emilerenaud/oscillope_extender/Project Outputs for oscilloscope_ext/PDF/Bill of Materials.PDF

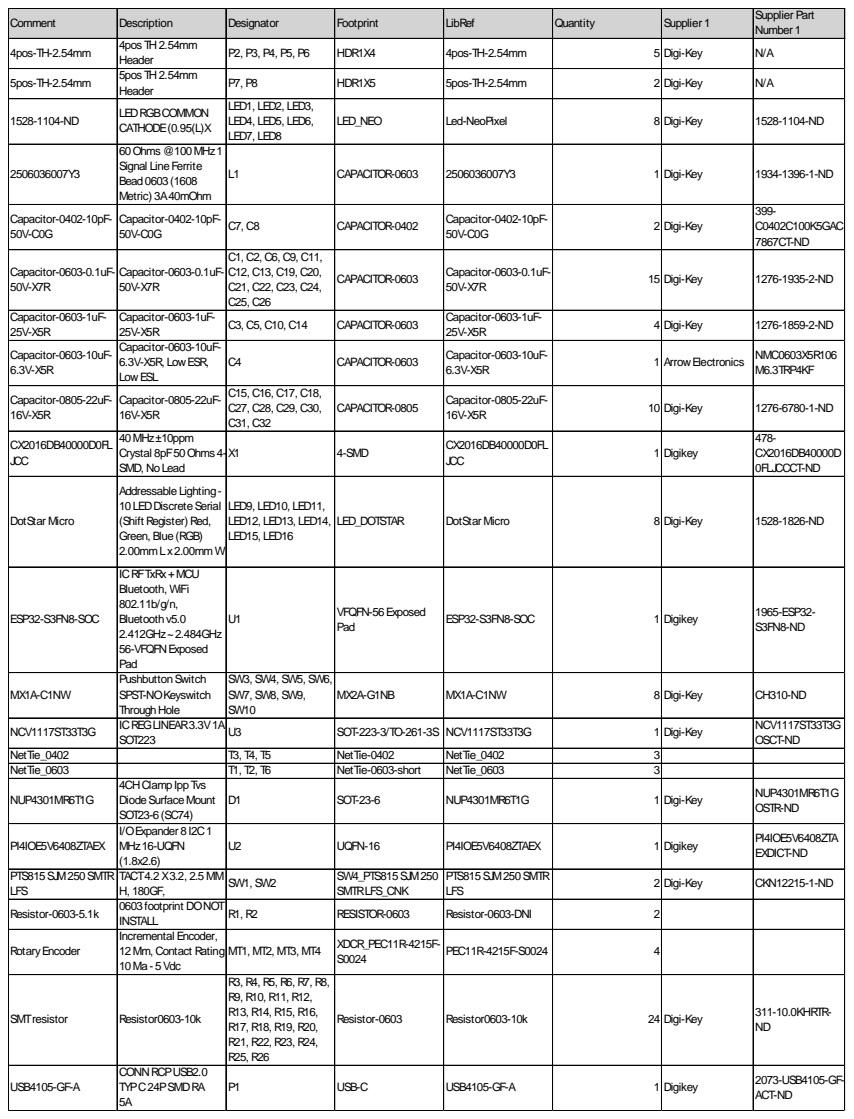
[picture p1: page 1]

Comment | Description | Designator | Footprint | LibRef | Quantity | Supplier 1 | Supplier Part Number 1

4pos-TH-2.54mm | 4pos TH2.54mm Header | P2, P3, P4, P5, P6 | HDR1X4 | 4pos-TH-2.54mm | 5 | Digi-Key | N/A

5pos-TH-2.54mm | 5pos TH2.54mm Header | P7, P8 | HDR1X5 | 5pos-TH-2.54mm | 2 | Digi-Key | N/A

1528-1104-ND | LEDRGBCOMMON CATHODE(0.95(L)X | LED1, LED2, LED3, LED4, LED5, LED6, LED7, LED8 | LED_NEO | Led-NeoPixel | 8 | Digi-Key | 1528-1104-ND

2506036007Y3 | 60Ohms@100MHz1 Signal LineFerrite Bead0603(1608 Metric) 3A40mOhm | L1 | CAPACITOR-0603 | 2506036007Y3 | 1 | Digi-Key | 1934-1396-1-ND

Capacitor-0402-10pF-50V-C0G | Capacitor-0402-10pF-50V-C0G | C7, C8 | CAPACITOR-0402 | Capacitor-0402-10pF-50V-C0G | 2 | Digi-Key | 399-C0402C100K5GAC 7867CT-ND

Capacitor-0603-0.1uF-50V-X7R | Capacitor-0603-0.1uF-50V-X7R | C1, C2, C6, C9, C11, C12, C13, C19, C20, C21, C22, C23, C24, C25, C26 | CAPACITOR-0603 | Capacitor-0603-0.1uF-50V-X7R | 15 | Digi-Key | 1276-1935-2-ND

Capacitor-0603-1uF-25V-X5R | Capacitor-0603-1uF-25V-X5R | C3, C5, C10, C14 | CAPACITOR-0603 | Capacitor-0603-1uF-25V-X5R | 4 | Digi-Key | 1276-1859-2-ND

Capacitor-0603-10uF-6.3V-X5R | Capacitor-0603-10uF-6.3V-X5R, LowESR, LowESL | C4 | CAPACITOR-0603 | Capacitor-0603-10uF-6.3V-X5R | 1 | ArrowElectronics | NMC0603X5R106 M6.3TRP4KF

Capacitor-0805-22uF-16V-X5R | Capacitor-0805-22uF-16V-X5R | C15, C16, C17, C18, C27, C28, C29, C30, C31, C32 | CAPACITOR-0805 | Capacitor-0805-22uF-16V-X5R | 10 | Digi-Key | 1276-6780-1-ND

CX2016DB40000D0FL JCC | 40MHz±10ppm Crystal 8pF50Ohms 4-SMD, NoLead | X1 | 4-SMD | CX2016DB40000D0FL JCC | 1 | Digikey | 478-CX2016DB40000D 0FLJCCCT-ND

DotStar Micro | Addressable Lighting-10LEDDiscreteSerial (Shift Register) Red, Green, Blue(RGB) 2.00mmLx2.00mmW | LED9, LED10, LED11, LED12, LED13, LED14, LED15, LED16 | LED_DOTSTAR | DotStar Micro | 8 | Digi-Key | 1528-1826-ND

ESP32-S3FN8-SOC | ICRFTxRx+MCU Bluetooth, WiFi 802.11b/g/n, Bluetoothv5.0 2.412GHz~2.484GHz 56-VFQFNExposed Pad | U1 | VFQFN-56Exposed Pad | ESP32-S3FN8-SOC | 1 | Digikey | 1965-ESP32-S3FN8-ND

MX1A-C1NW | PushbuttonSwitch SPST-NOKeyswitch ThroughHole | SW3, SW4, SW5, SW6, SW7, SW8, SW9, SW10 | MX2A-G1NB | MX1A-C1NW | 8 | Digi-Key | CH310-ND

NCV1117ST33T3G | ICREGLINEAR3.3V1A SOT223 | U3 | SOT-223-3/TO-261-3S | NCV1117ST33T3G | 1 | Digi-Key | NCV1117ST33T3G OSCT-ND

NetTie_0402 | | T3, T4, T5 | NetTie-0402 | NetTie_0402 | 3
NetTie_0603 | | T1, T2, T6 | NetTie-0603-short | NetTie_0603 | 3
NUP4301MR6T1G | 4CHClampIppTvs DiodeSurfaceMount SOT23-6(SC74) | D1 | SOT-23-6 | NUP4301MR6T1G | 1 | Digi-Key | NUP4301MR6T1G OSTR-ND

PI4IOE5V6408ZTAEX | I/OExpander 8I2C1 MHz16-UQFN (1.8x2.6) | U2 | UQFN-16 | PI4IOE5V6408ZTAEX | 1 | Digikey | PI4IOE5V6408ZTA EXDICT-ND

PTS815SJM250SMTR LFS | TACT4.2X3.2, 2.5 MM H, 180GF, | SW1, SW2 | SW4_PTS815SJM250 SMTRLFS_CNK | PTS815SJM250SMTR LFS | 2 | Digi-Key | CKN12215-1-ND

Resistor-0603-5.1k | 0603footprint DONOT INSTALL | R1, R2 | RESISTOR-0603 | Resistor-0603-DNI | 2

RotaryEncoder | Incremental Encoder, 12Mm, Contact Rating 10Ma- 5Vdc | MT1, MT2, MT3, MT4 | XDCR_PEC11R-4215F-S0024 | PEC11R-4215F-S0024 | 4

SMTresistor | Resistor0603-10k | R3, R4, R5, R6, R7, R8, R9, R10, R11, R12, R13, R14, R15, R16, R17, R18, R19, R20, R21, R22, R23, R24, R25, R26 | Resistor-0603 | Resistor0603-10k | 24 | Digi-Key | 311-10.0KHRTR-ND

USB4105-GF-A | CONNRCPUSB2.0 TYPC24PSMDRA 5A | P1 | USB-C | USB4105-GF-A | 1 | Digikey | 2073-USB4105-GF-ACT-ND
