emilerenaud/oscillope_extender/CAD/oscilloscope_ext_assy.SLDASM

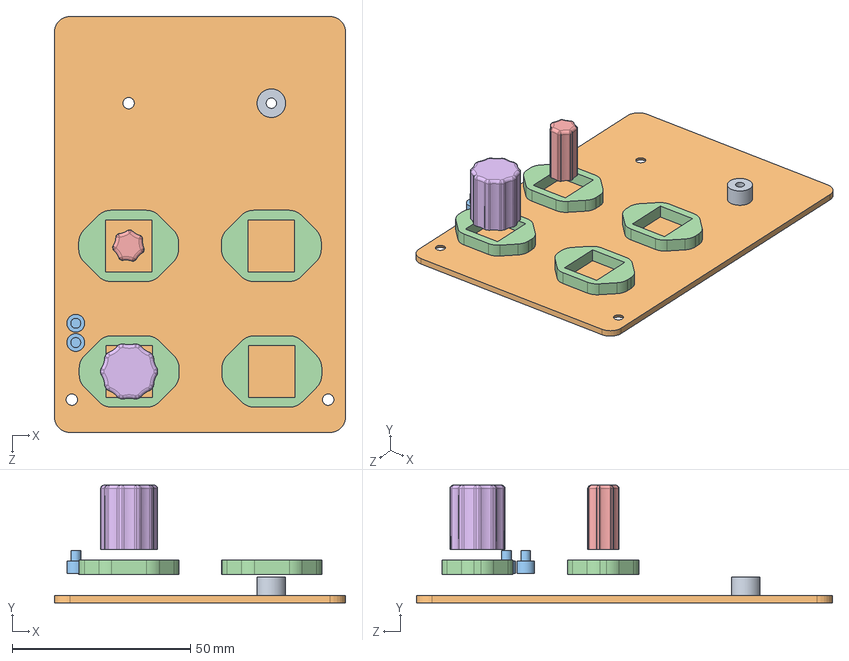
[picture p2: CAD file, 2025-07-10]
CAD/oscilloscope_ext_assy.SLDASM
81.6 x 33.0 x 116.6 mm
big_knob2
small_knob
diffuser x 4
pin_button x 2
base_plate
base_plate_insert
