emilerenaud/oscillope_extender/CAD/keycap.SLDPRT

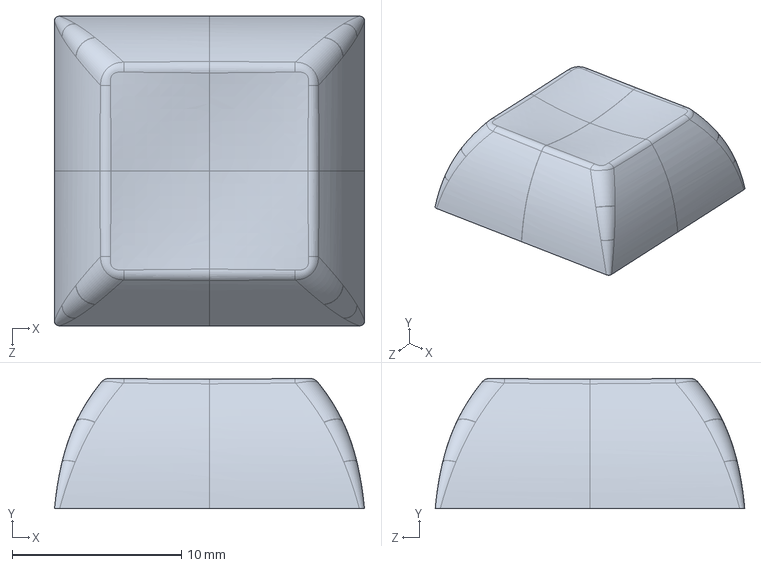
[picture p3: CAD file, 2025-07-10]
CAD/keycap.SLDPRT
18.3 x 7.69 x 18.3 mm
