emilerenaud/oscillope_extender/CAD/pin_button.SLDPRT

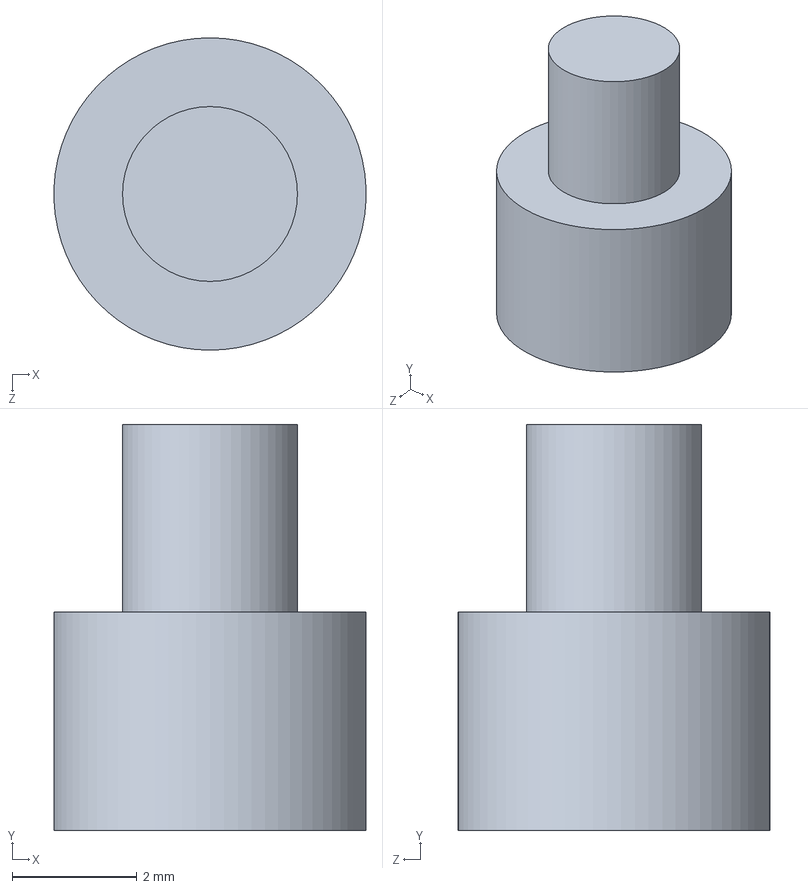
[picture p4: CAD file, 2025-07-10]
CAD/pin_button.SLDPRT
4.99 x 6.50 x 5.00 mm
