emilerenaud/oscillope_extender/CAD/top_casing.SLDPRT

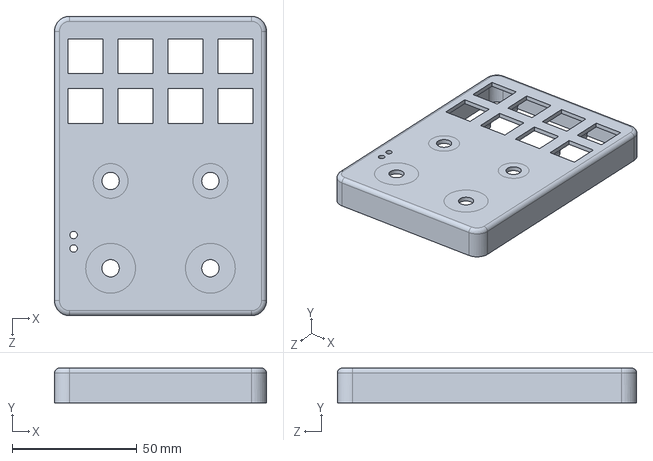
[picture p5: CAD file, 2025-07-10]
CAD/top_casing.SLDPRT
85.0 x 14.0 x 120.0 mm
