emilerenaud/oscillope_extender/CAD/base_plate_insert.SLDPRT

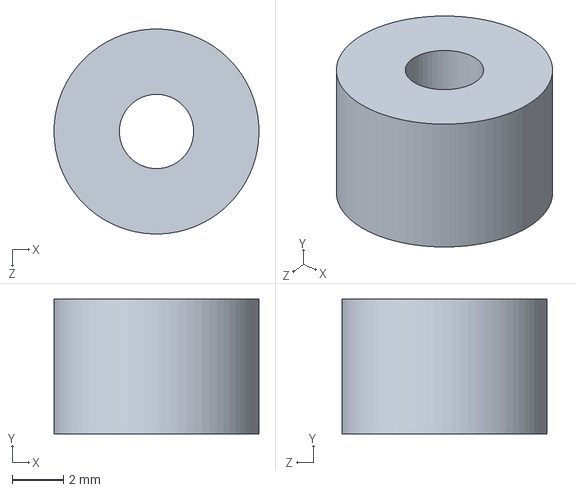
[picture p6: CAD file, 2025-07-10]
CAD/base_plate_insert.SLDPRT
8.00 x 5.25 x 8.00 mm
