emilerenaud/oscillope_extender/CAD/small_knob.SLDPRT

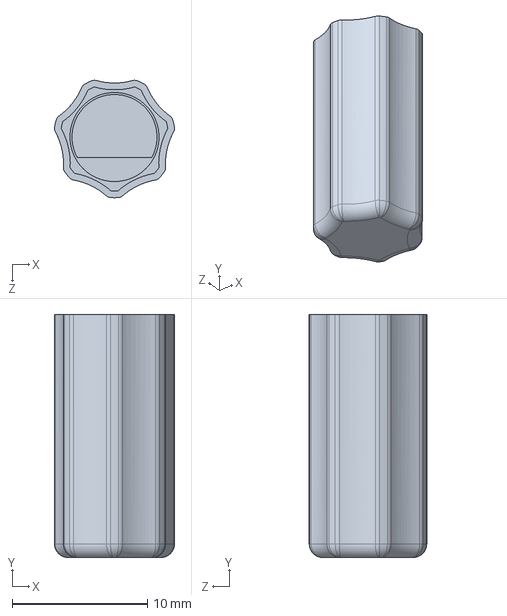
[picture p7: CAD file, 2025-07-10]
CAD/small_knob.SLDPRT
8.90 x 18.0 x 8.71 mm
