emilerenaud/oscillope_extender/CAD/base_plate.SLDPRT

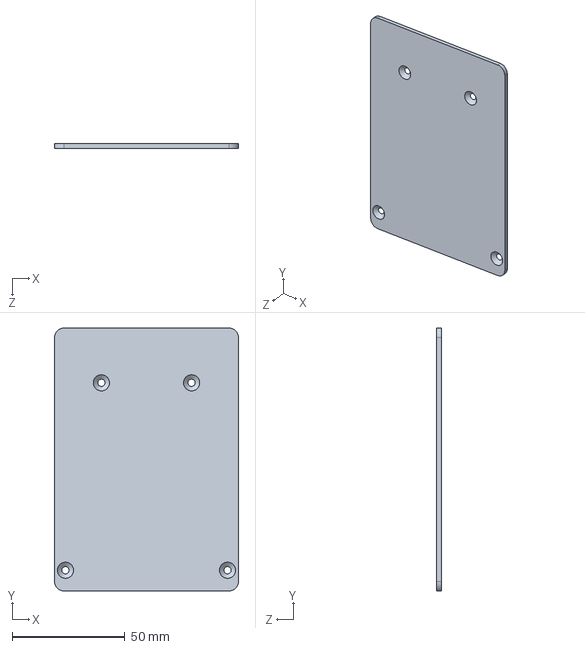
[picture p8: CAD file, 2025-07-10]
CAD/base_plate.SLDPRT
81.6 x 116.6 x 2.00 mm
