emilerenaud/oscillope_extender/CAD/diffuser.SLDPRT

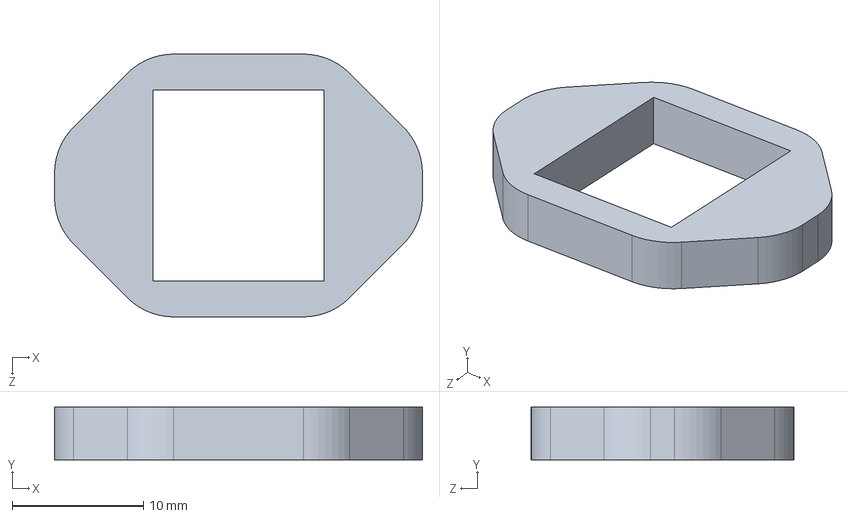
[picture p9: CAD file, 2025-07-10]
CAD/diffuser.SLDPRT
28.0 x 4.00 x 20.0 mm
