emilerenaud/oscillope_extender/CAD/big_knob2.SLDPRT

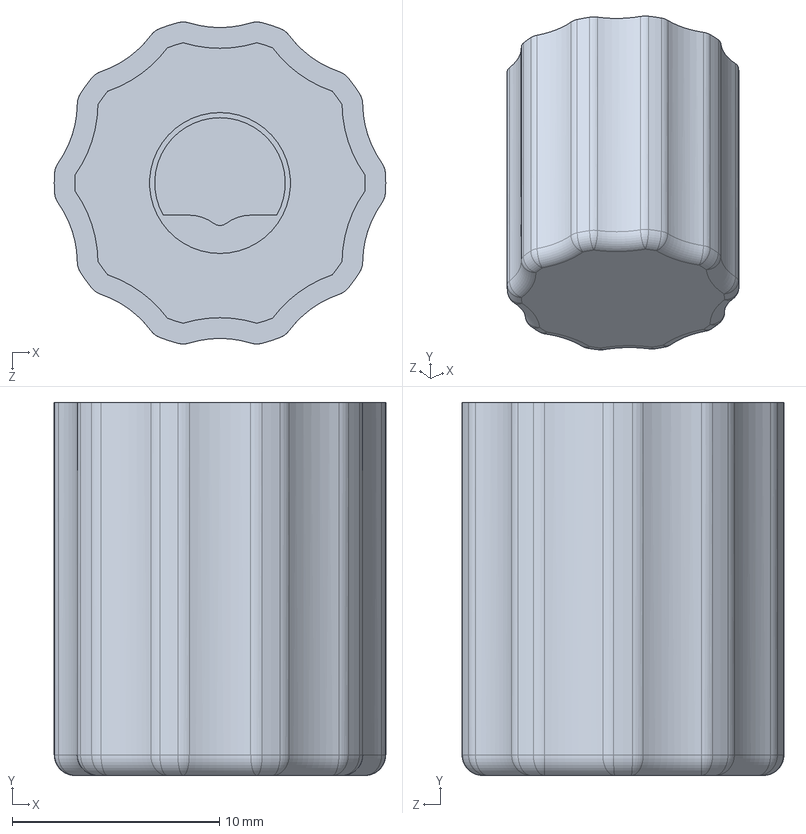
[picture p10: CAD file, 2025-07-10]
CAD/big_knob2.SLDPRT
16.0 x 18.0 x 15.5 mm
