emilerenaud/oscillope_extender/CAD/big_knob.SLDPRT

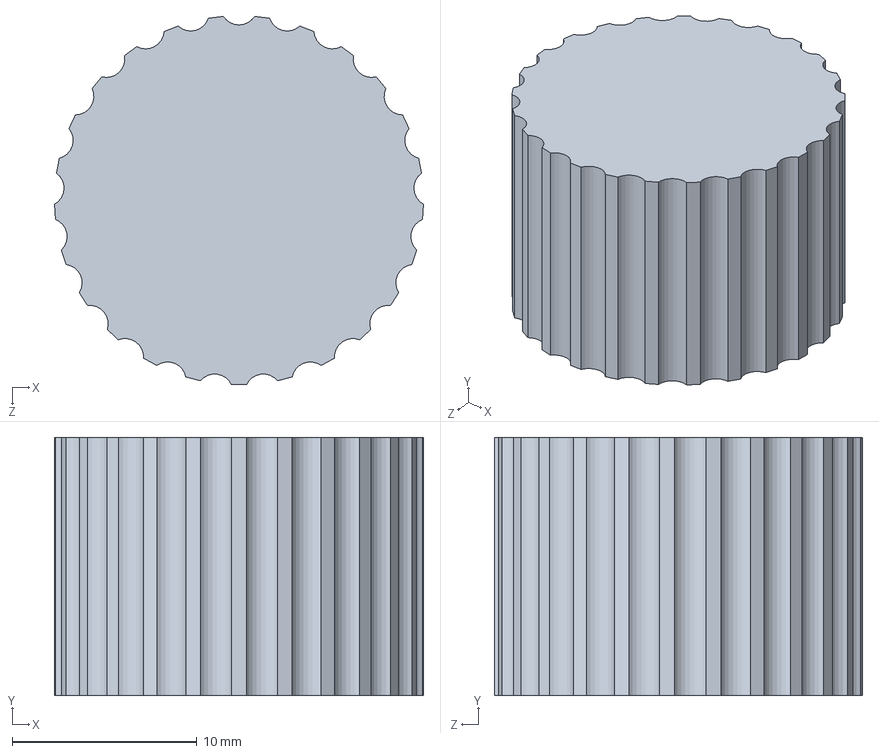
[picture p11: CAD file, 2025-06-17]
CAD/big_knob.SLDPRT
20.0 x 14.0 x 20.0 mm
