emilerenaud/oscillope_extender/CAD/light_ring_20mm.SLDPRT

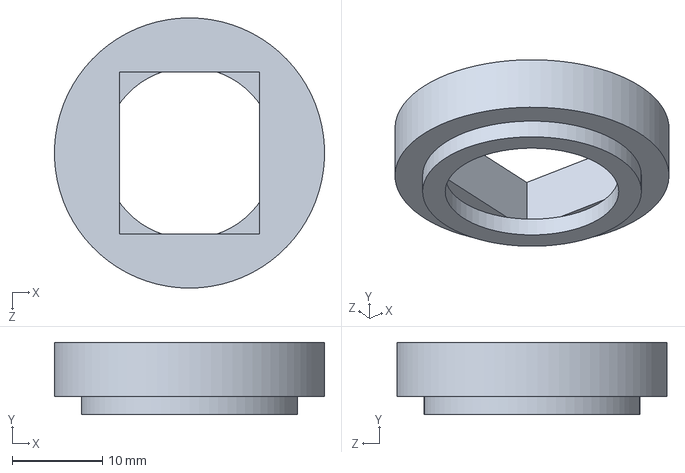
[picture p12: CAD file, 2025-06-17]
CAD/light_ring_20mm.SLDPRT
30.0 x 8.00 x 30.0 mm
