emilerenaud/oscillope_extender/CAD/Cherry MX.STEP

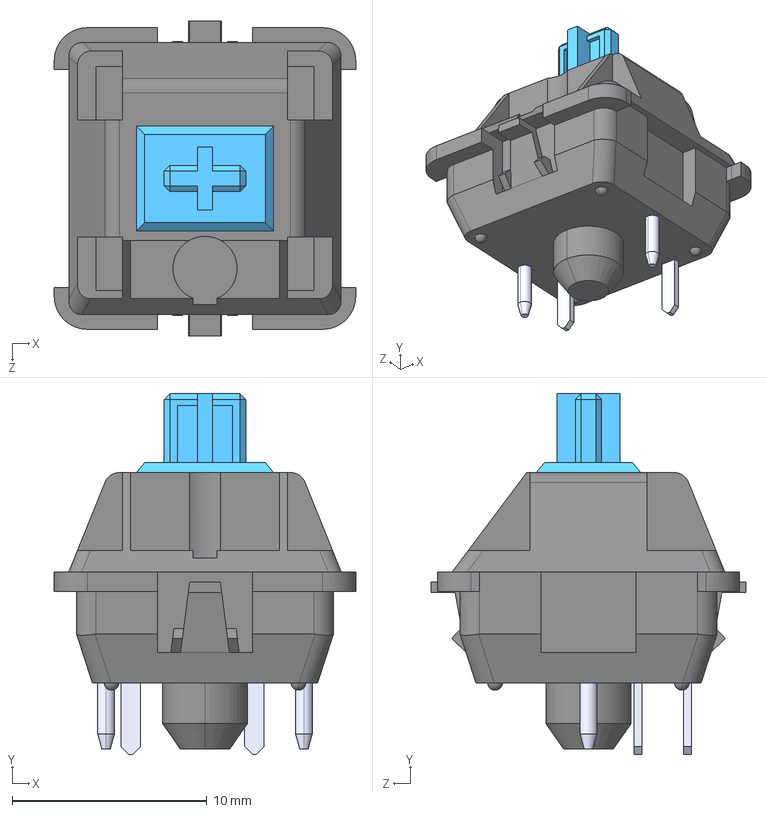
[picture p13: CAD file, 2025-06-17]
CAD/Cherry MX.STEP
15.5 x 18.5 x 16.2 mm
