emilerenaud/oscillope_extender/CAD/top_casing_light.SLDPRT

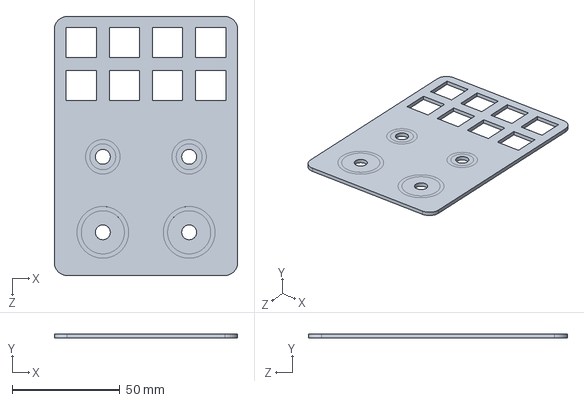
[picture p14: CAD file, 2025-06-17]
CAD/top_casing_light.SLDPRT
85.0 x 2.00 x 120.0 mm
