emilerenaud/oscillope_extender/CAD/encoder.stp

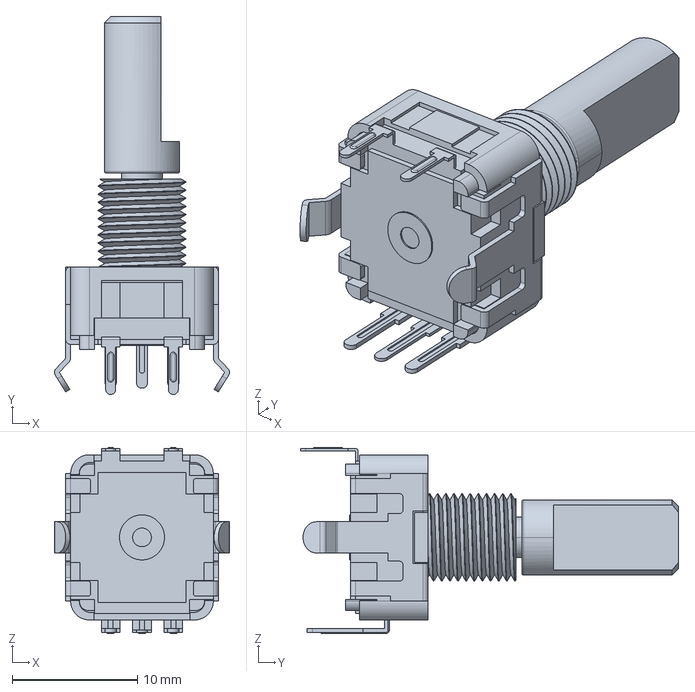
[picture p15: CAD file, 2025-06-17]
CAD/encoder.stp
14.0 x 30.2 x 14.9 mm
