emilerenaud/oscillope_extender/CAD/light_ring_20mm_inside.SLDPRT

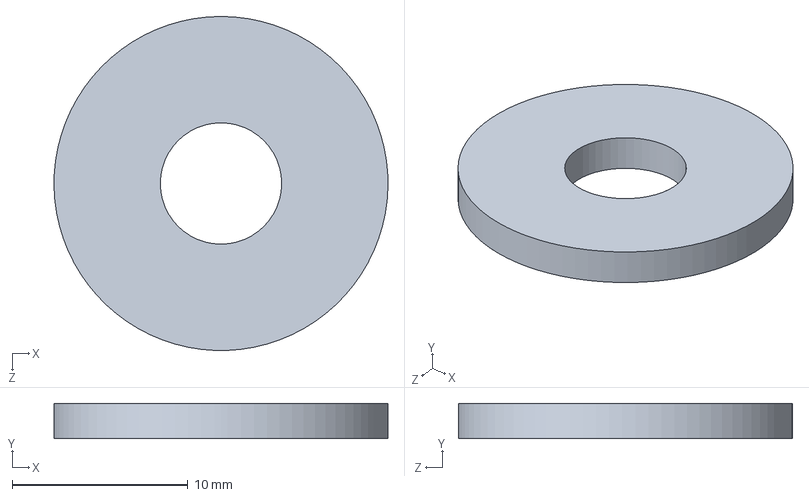
[picture p16: CAD file, 2025-06-17]
CAD/light_ring_20mm_inside.SLDPRT
19.0 x 2.00 x 19.0 mm
