emilerenaud/oscillope_extender/(list of files, cad)

Other CAD files:
CAD/DSA_Keycap_CherryMX.step
CAD/_STL/base_plate.STL
CAD/_STL/base_plate_insert.STL
CAD/_STL/big_knob.STL
CAD/_STL/big_knob2.STL
CAD/_STL/diffuser.STL
CAD/_STL/keycap.STL
CAD/_STL/light_ring_20mm.STL
CAD/_STL/light_ring_20mm_inside.STL
CAD/_STL/pin_button.STL
CAD/_STL/small_knob.STL
CAD/_STL/top_casing.STL
CAD/_STL/top_casing_light.STL
