emilerenaud/oscillope_extender/Project Outputs for oscilloscope_ext/PDF/Schematic Prints.PDF

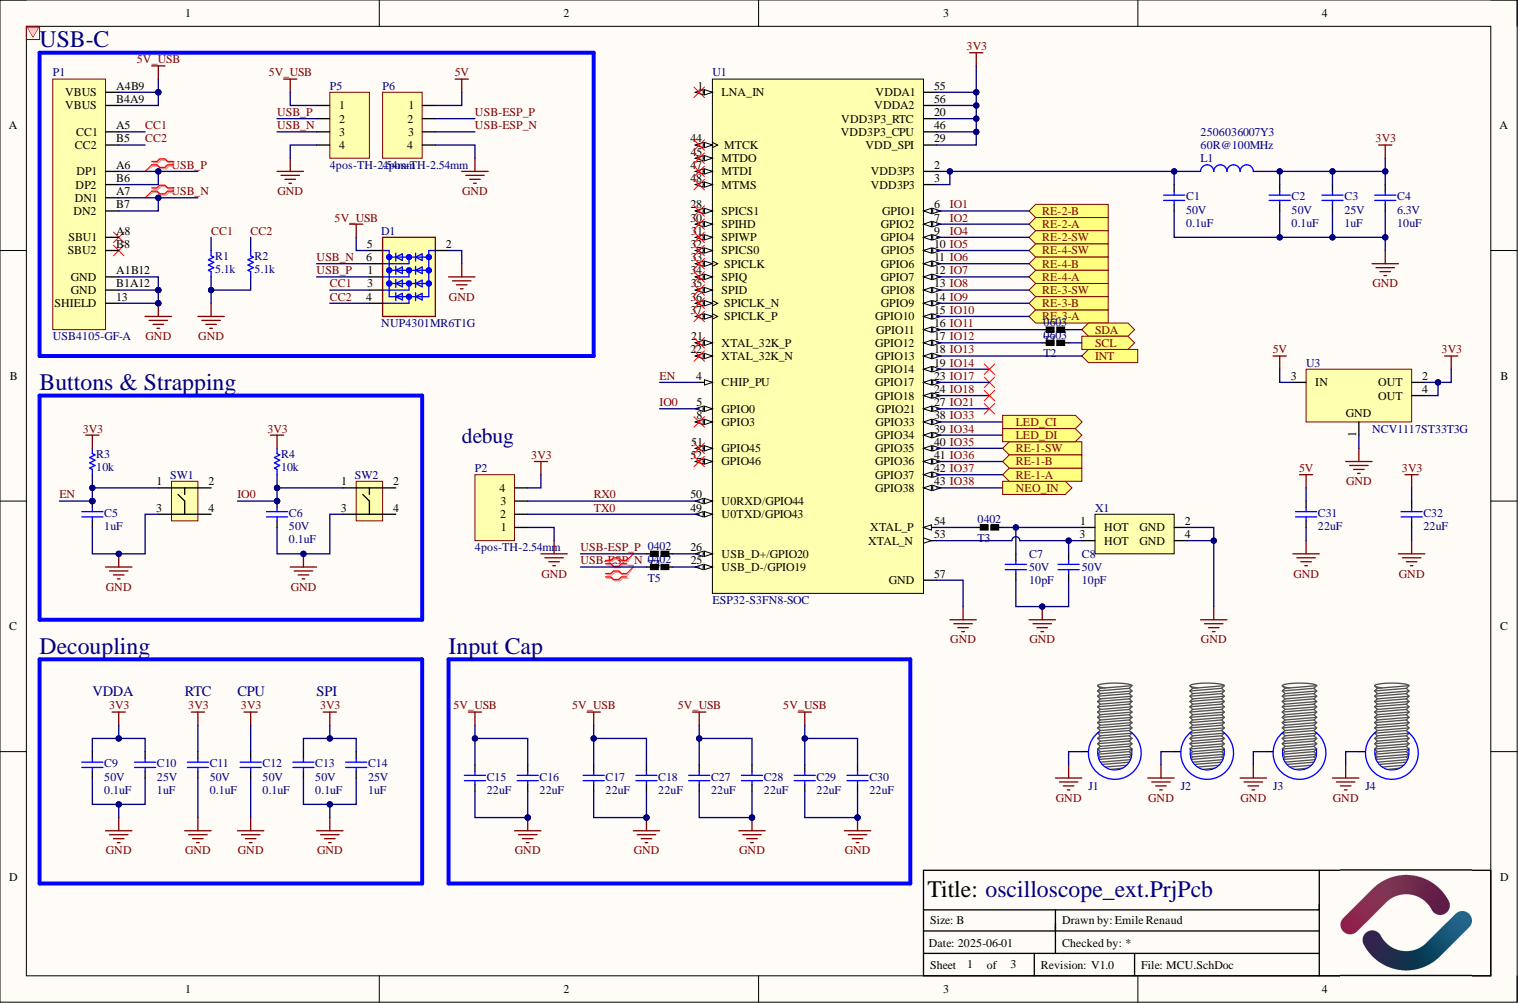
[picture p17: page 1]

Title: oscilloscope_ext.PrjPcb

Size: B | Drawn by: Emile Renaud

Date: 2025-06-01 | Checked by: *

1 3 Sheet of | V1.0 Revision: | MCU.SchDoc File:

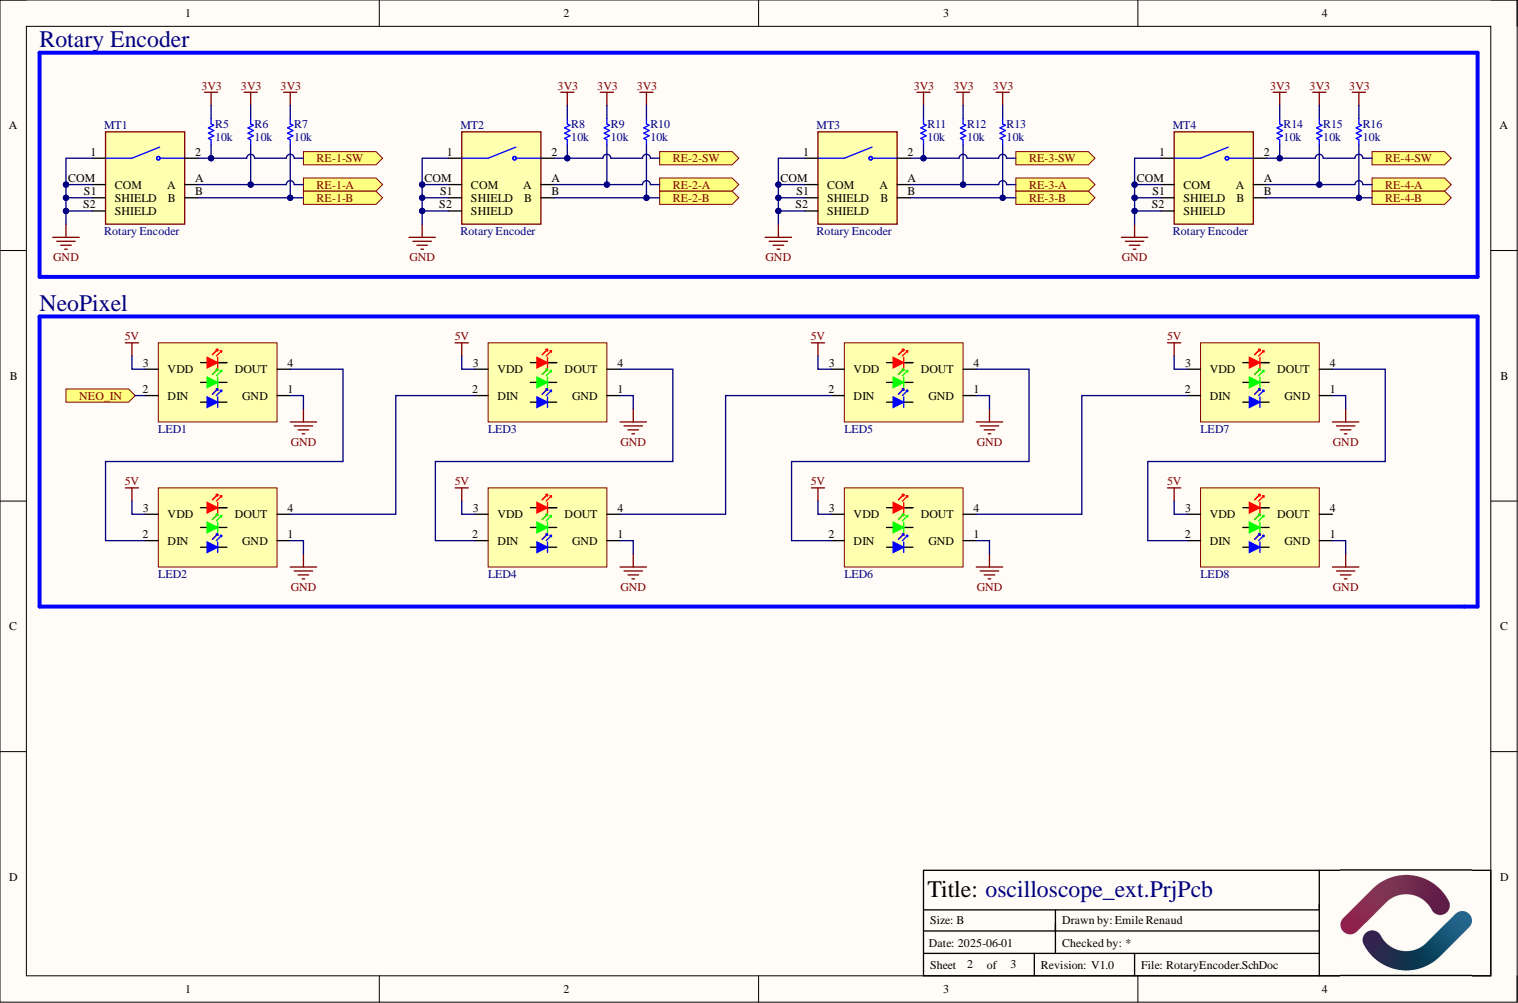
[picture p18: page 2]

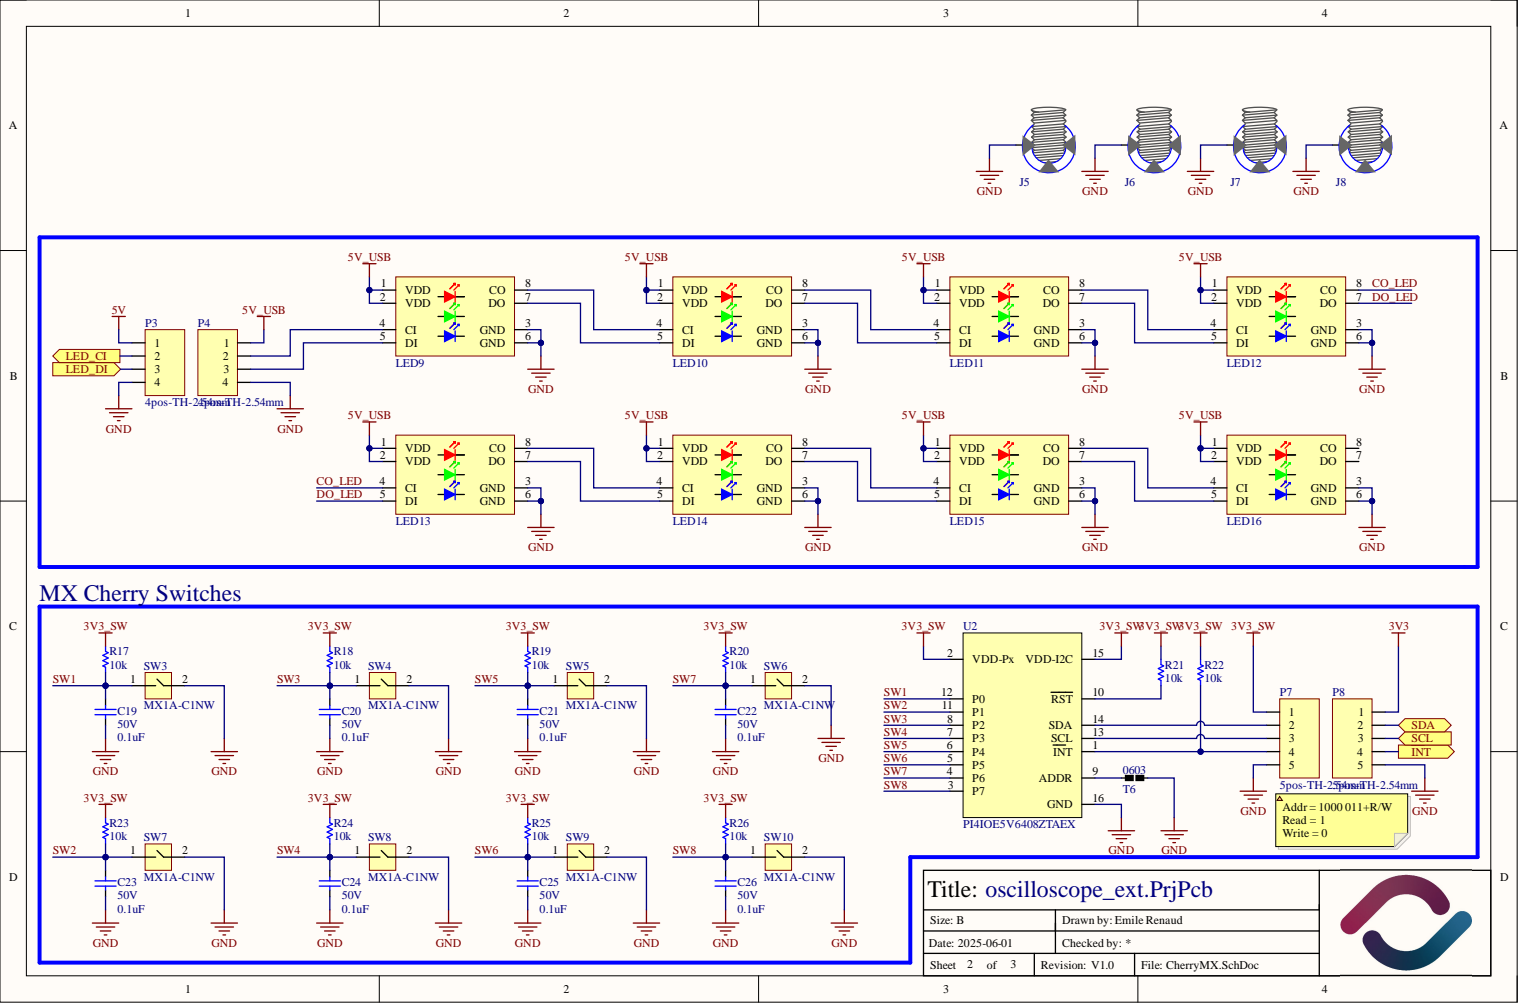
[picture p19: page 3]

J8 GND J7 GND J6 GND J5 GND
