emilerenaud/oscillope_extender/Project Outputs for oscilloscope_ext/PDF/PCB Prints.PDF

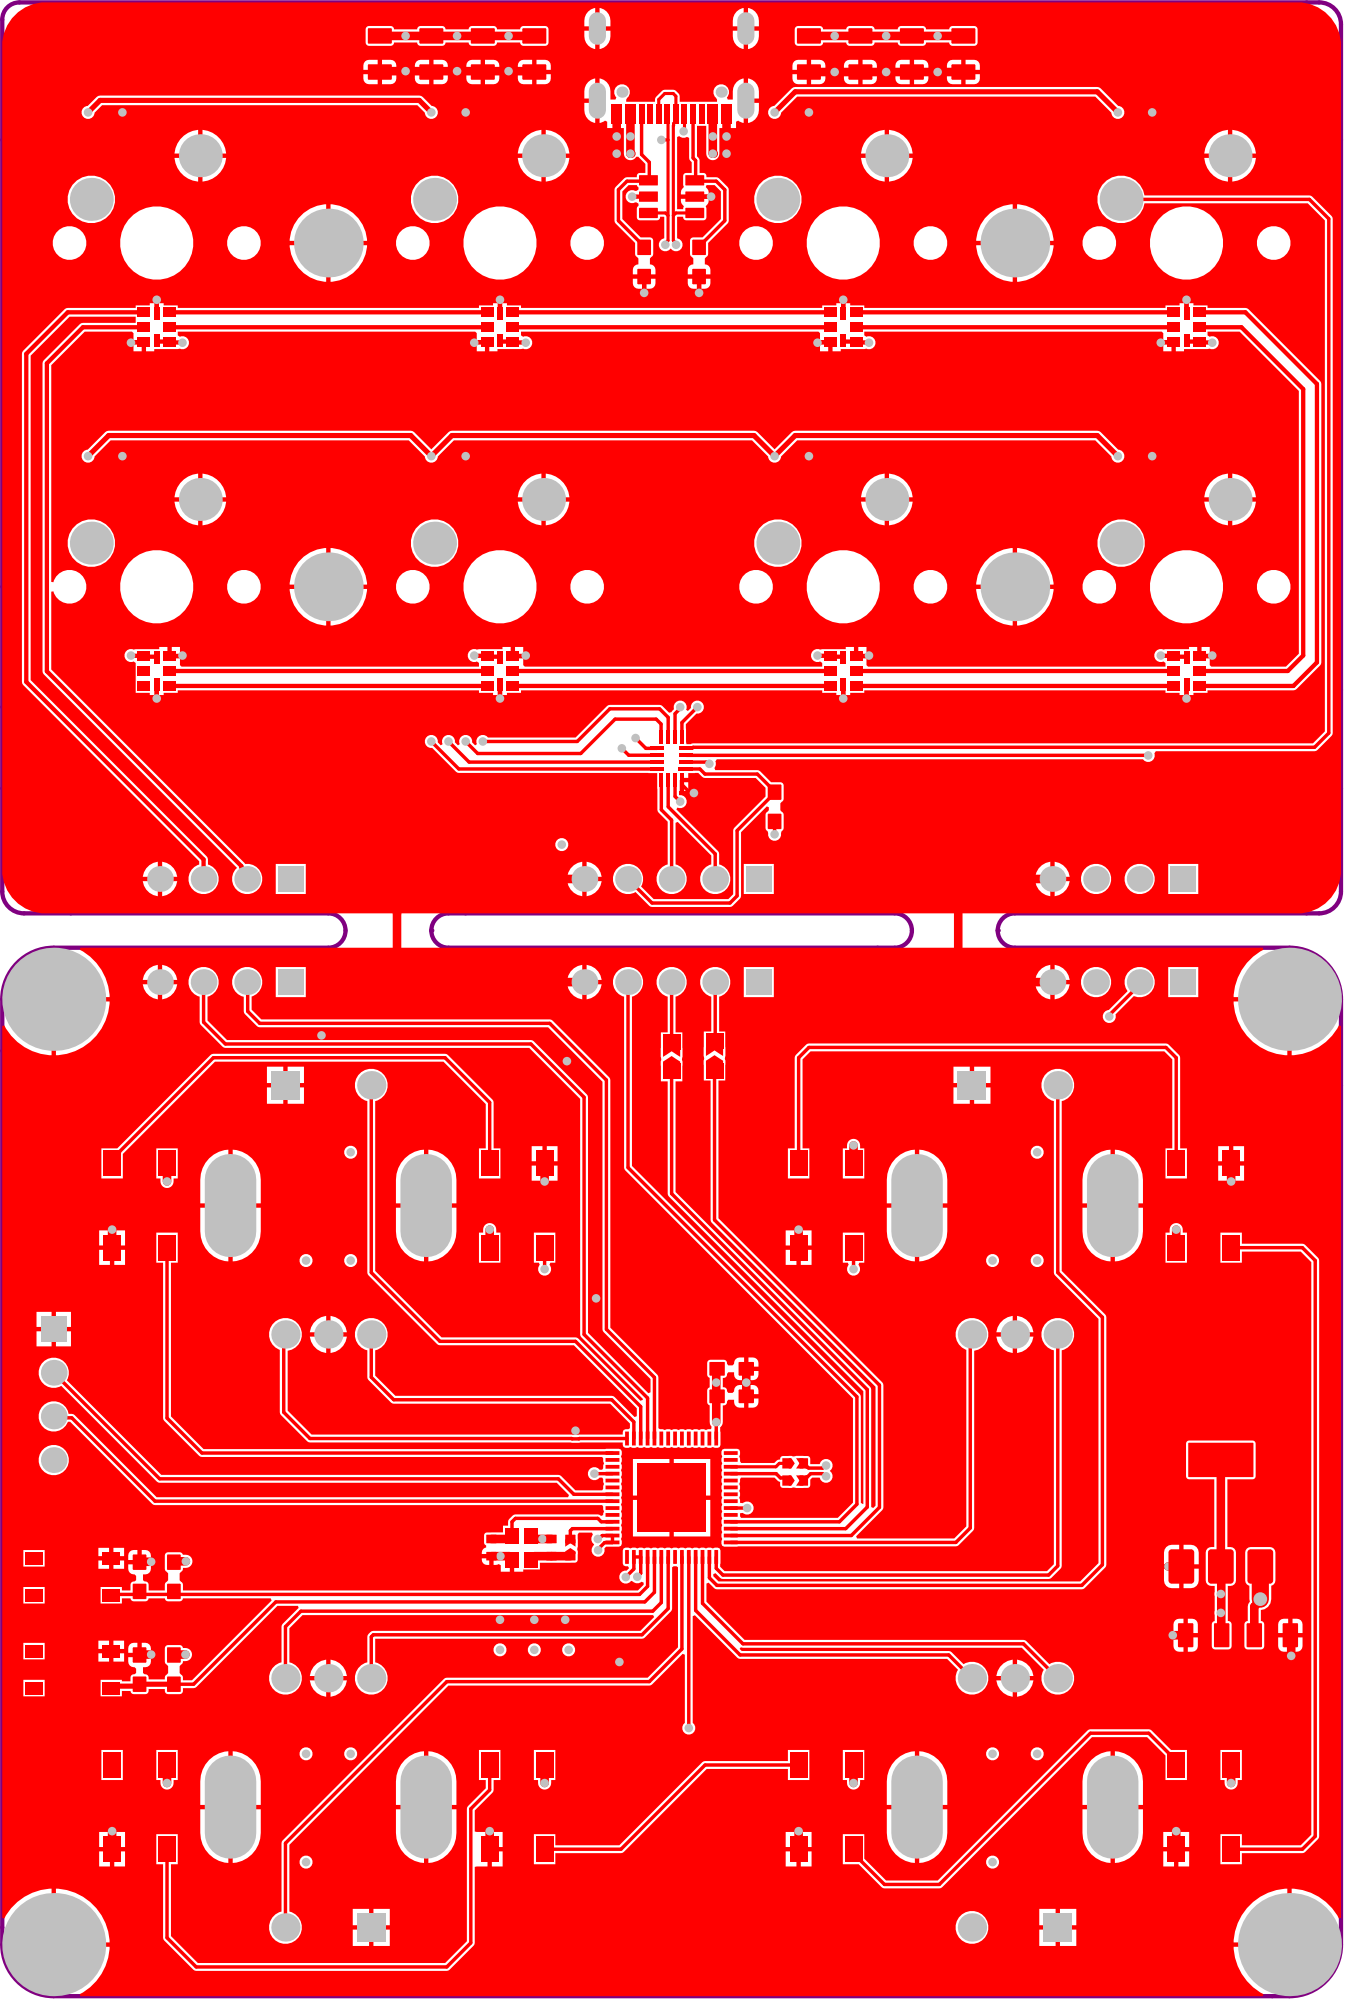
[picture p20: page 1]

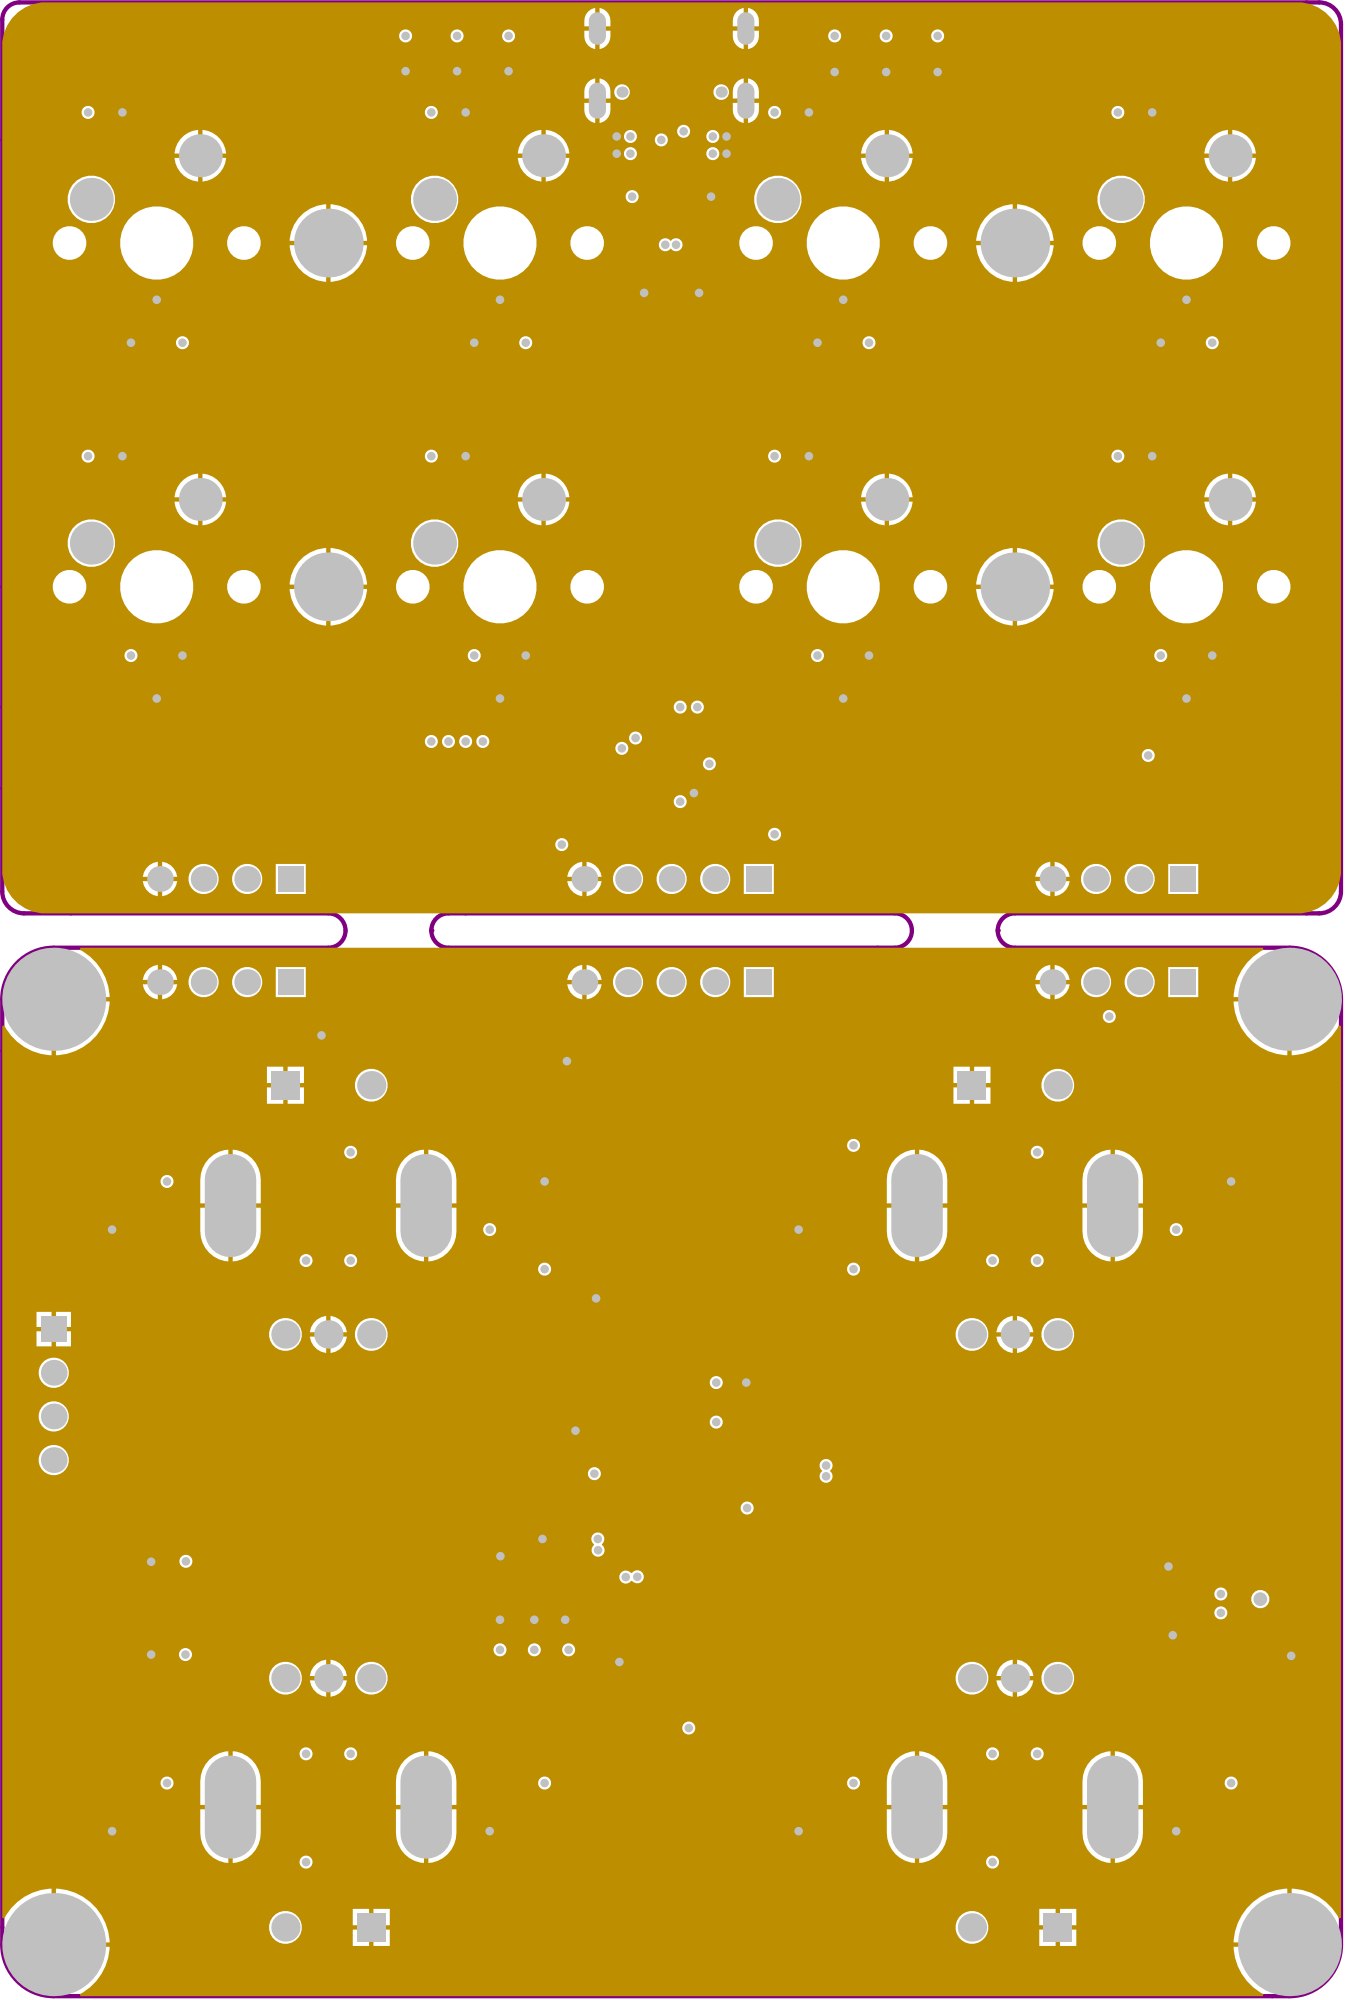
[picture p21: page 2]

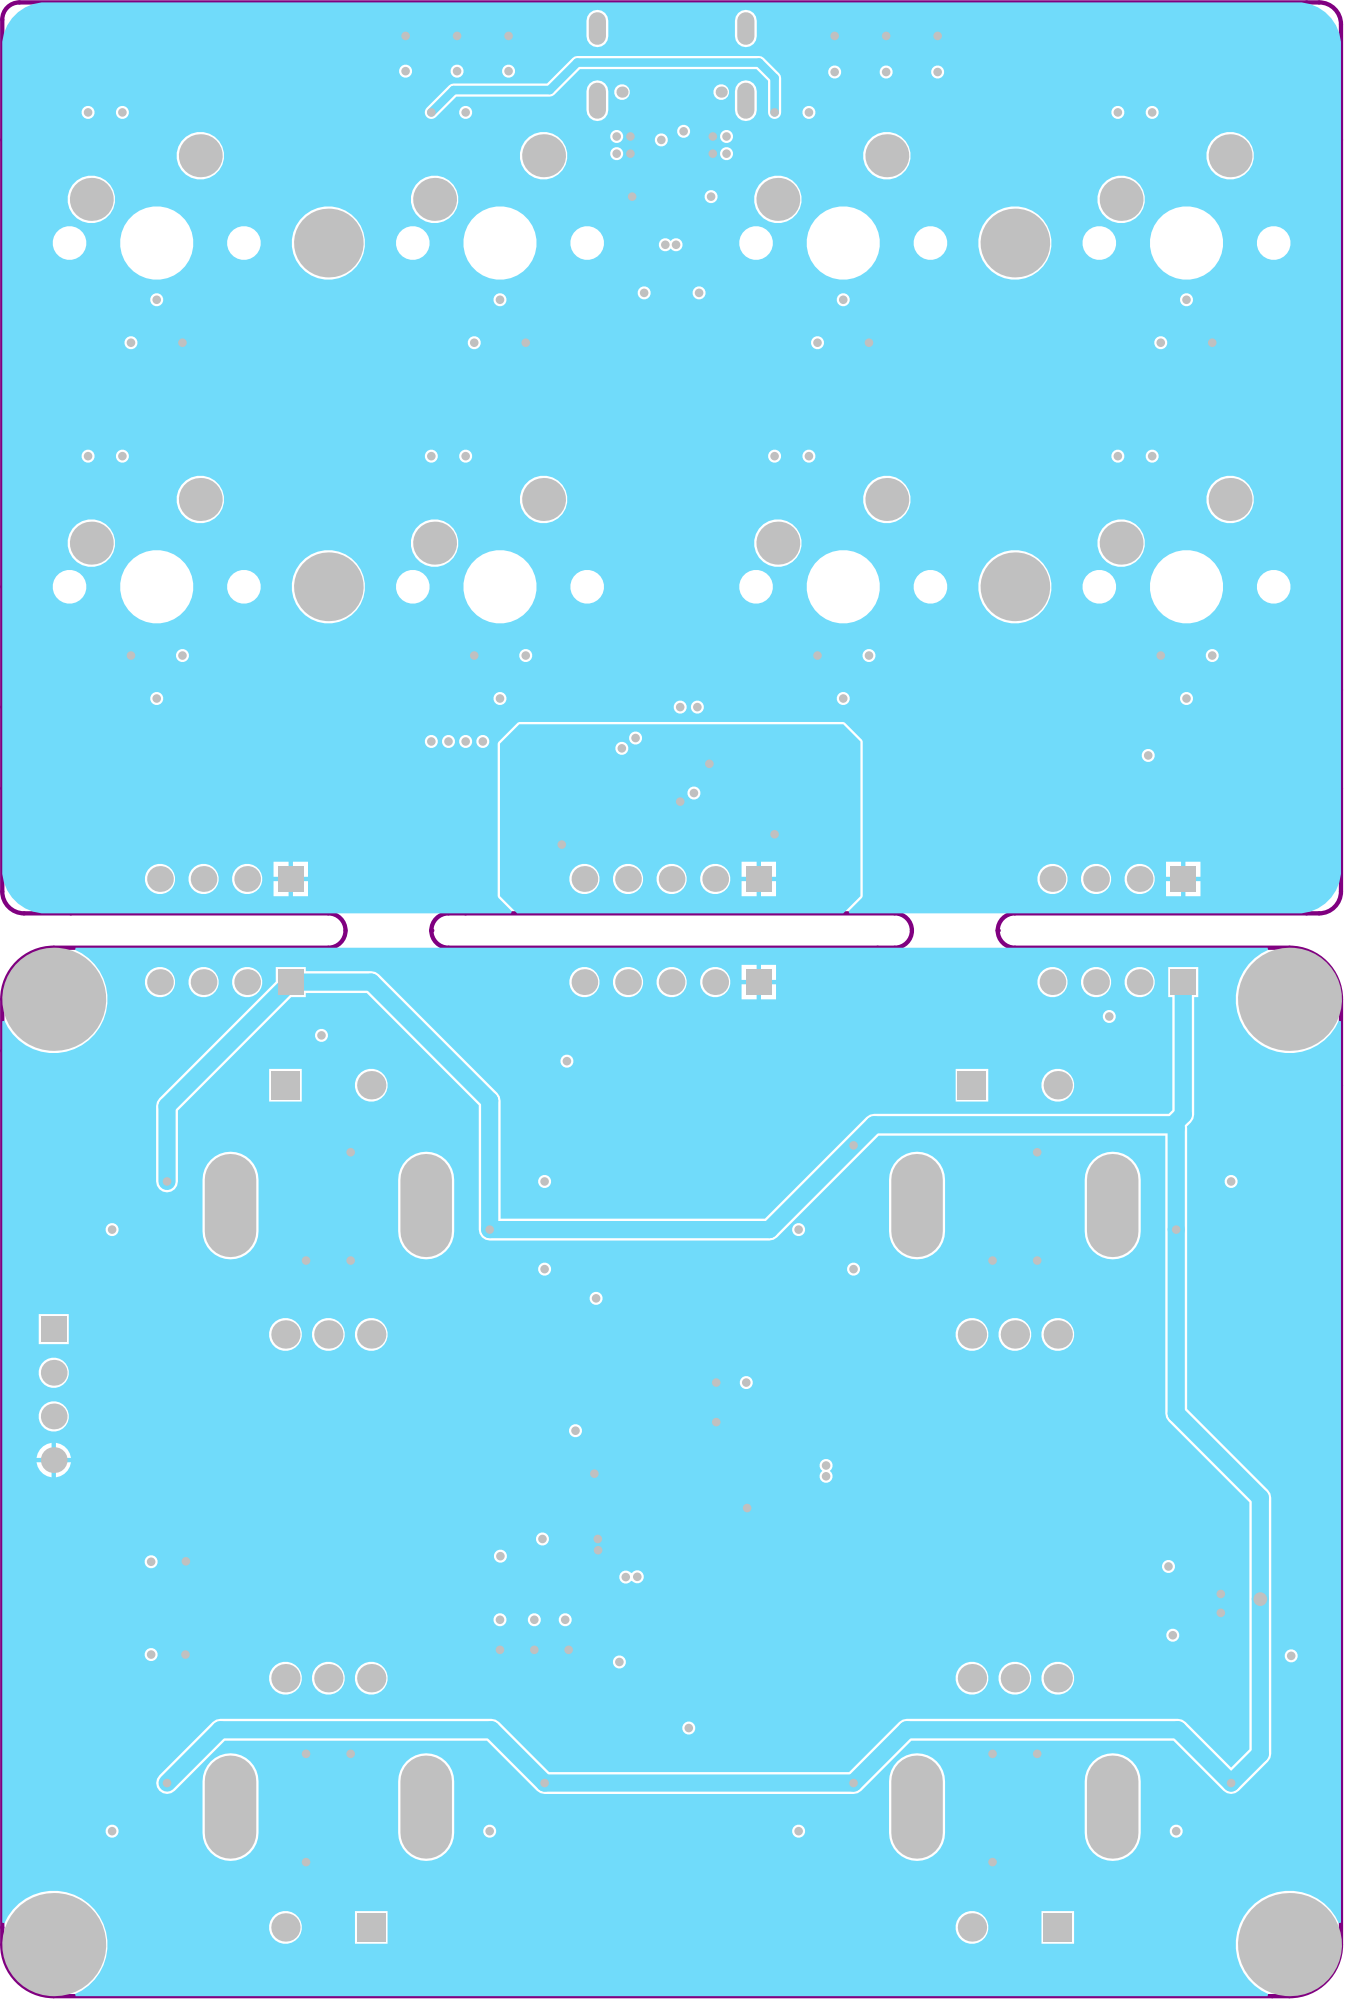
[picture p22: page 3]

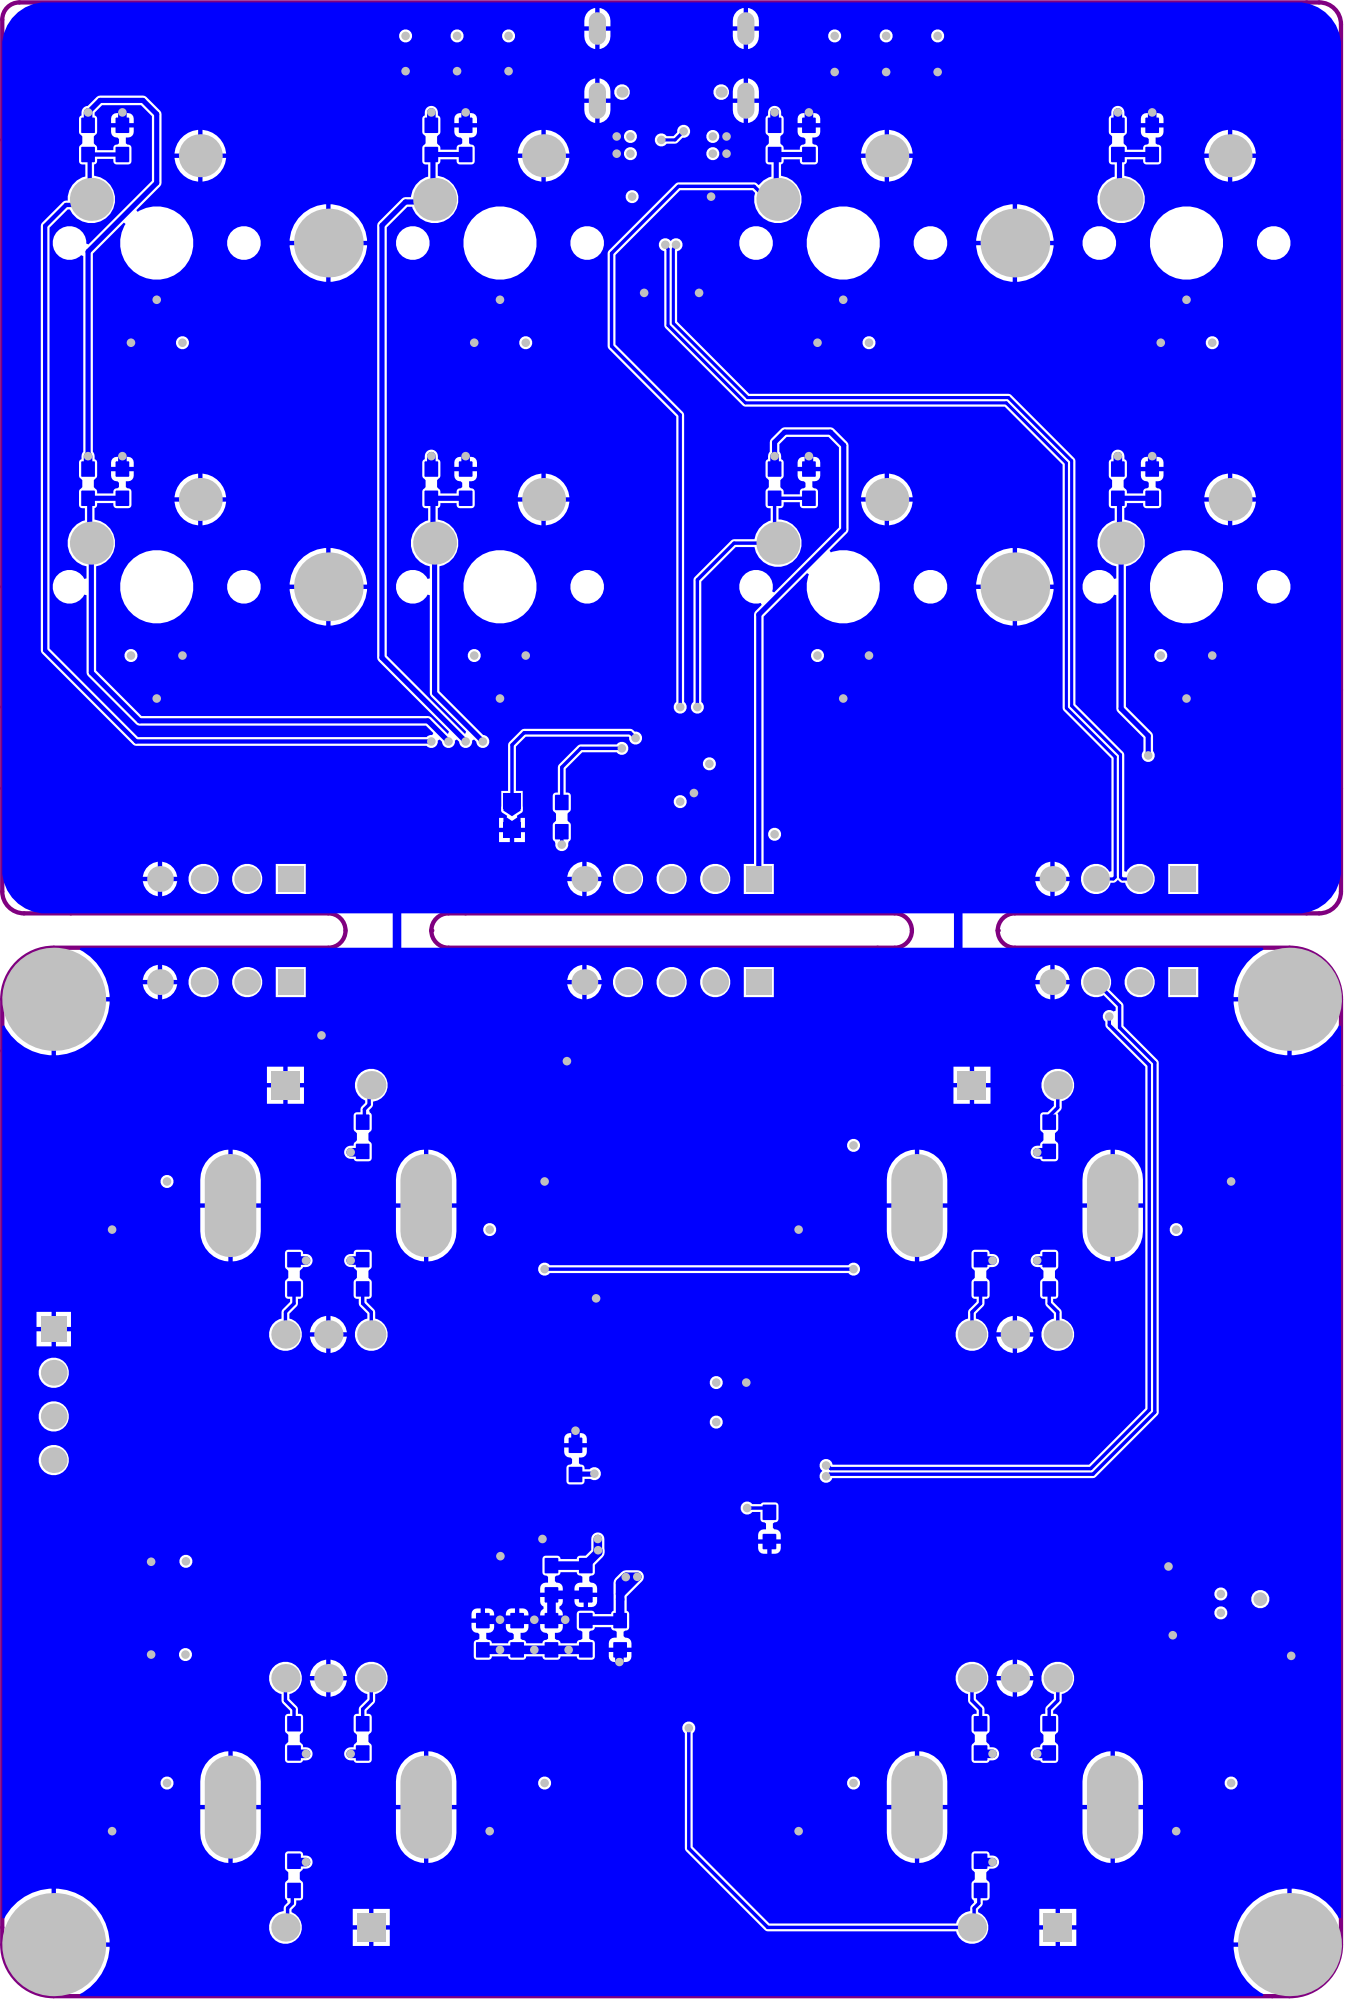
[picture p23: page 4]

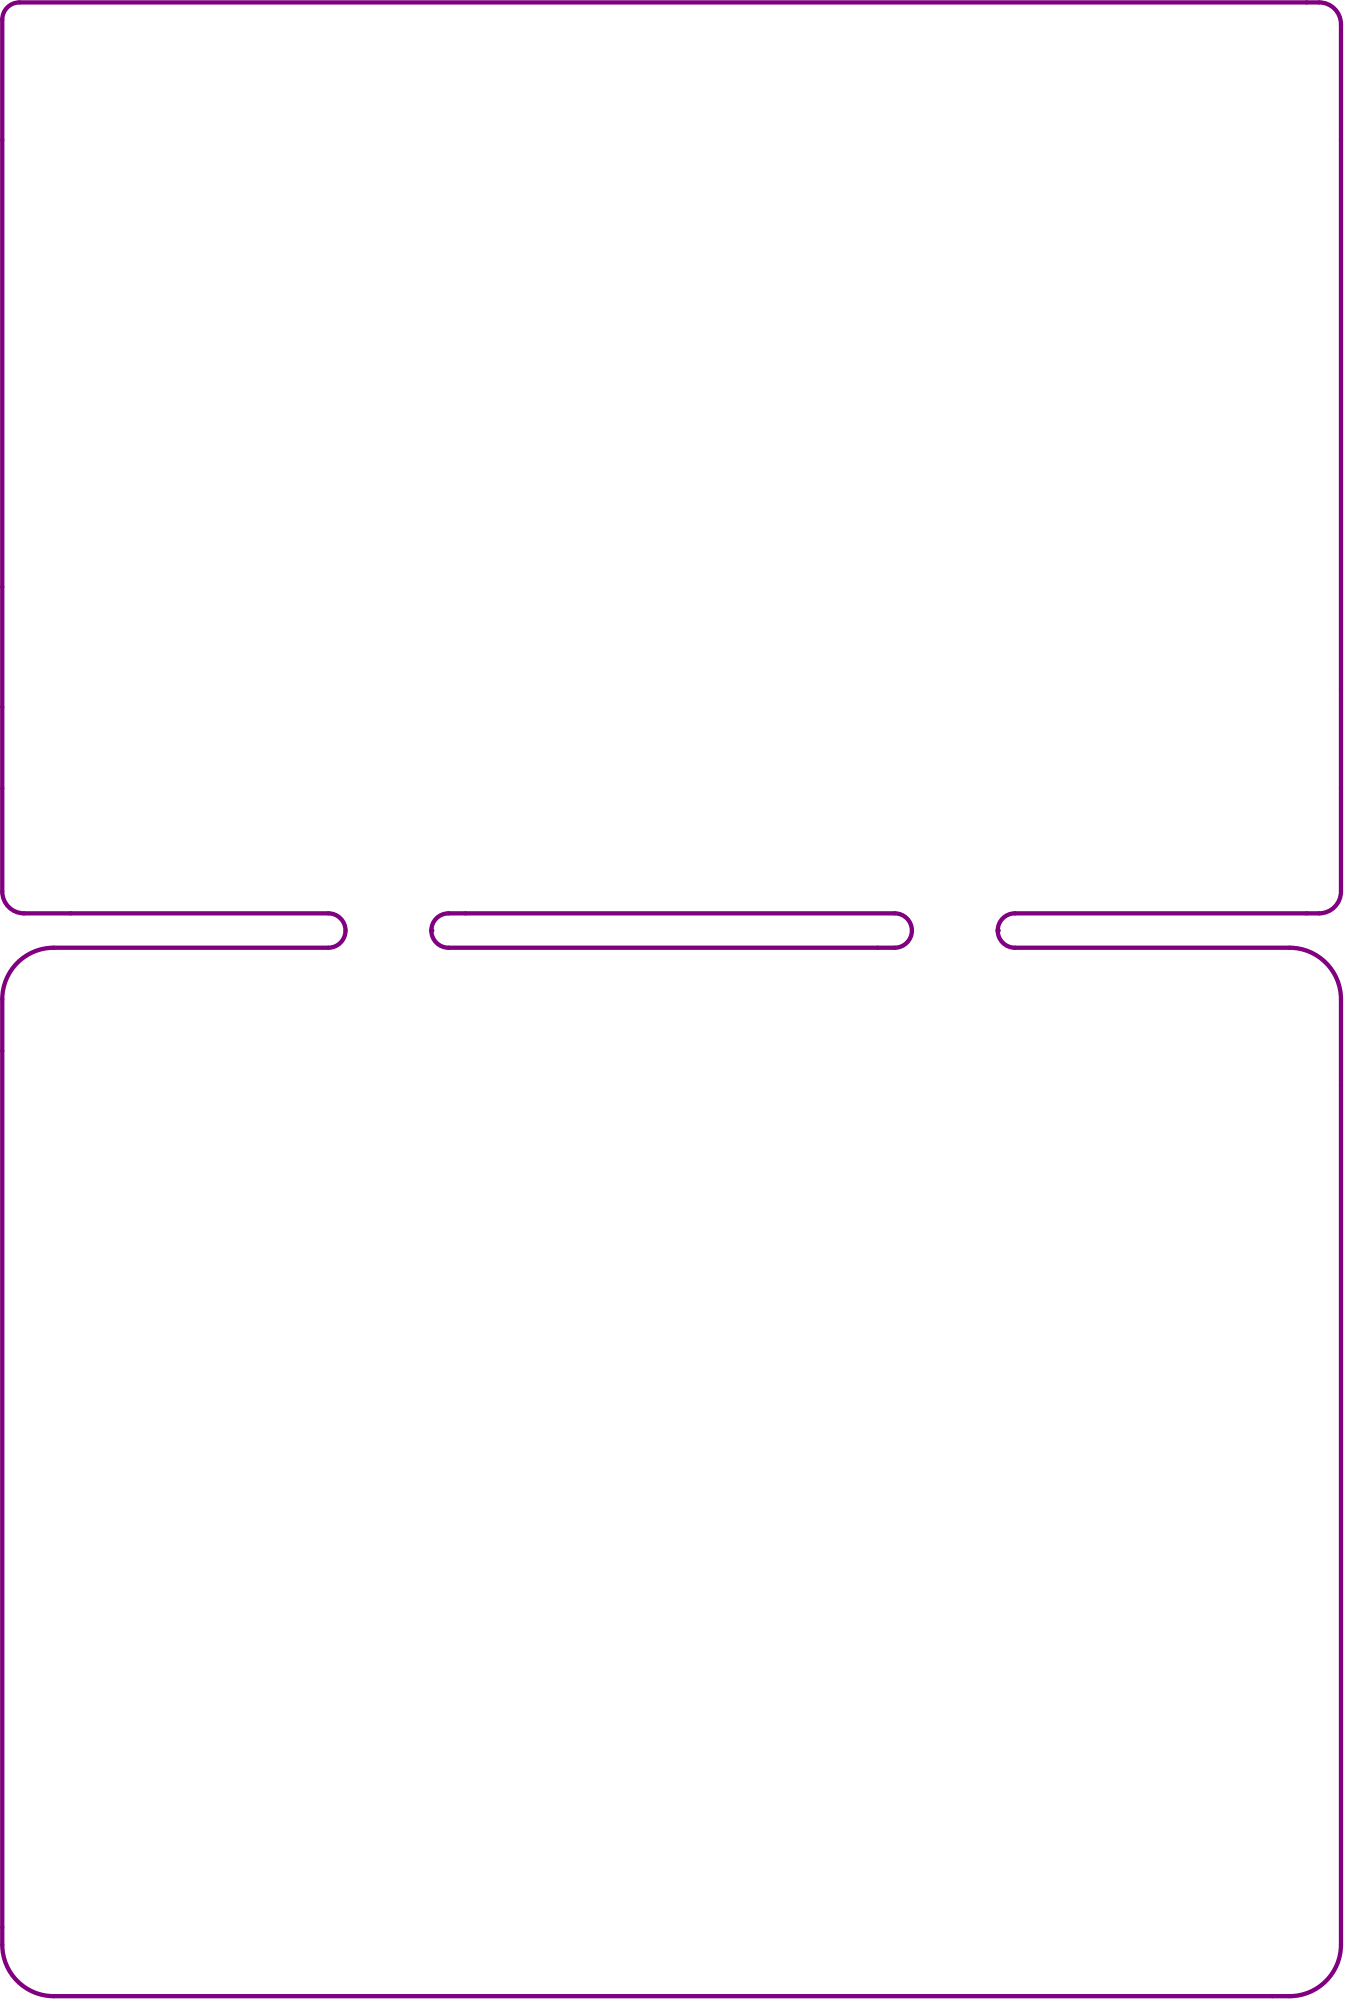
[picture p24: page 5]

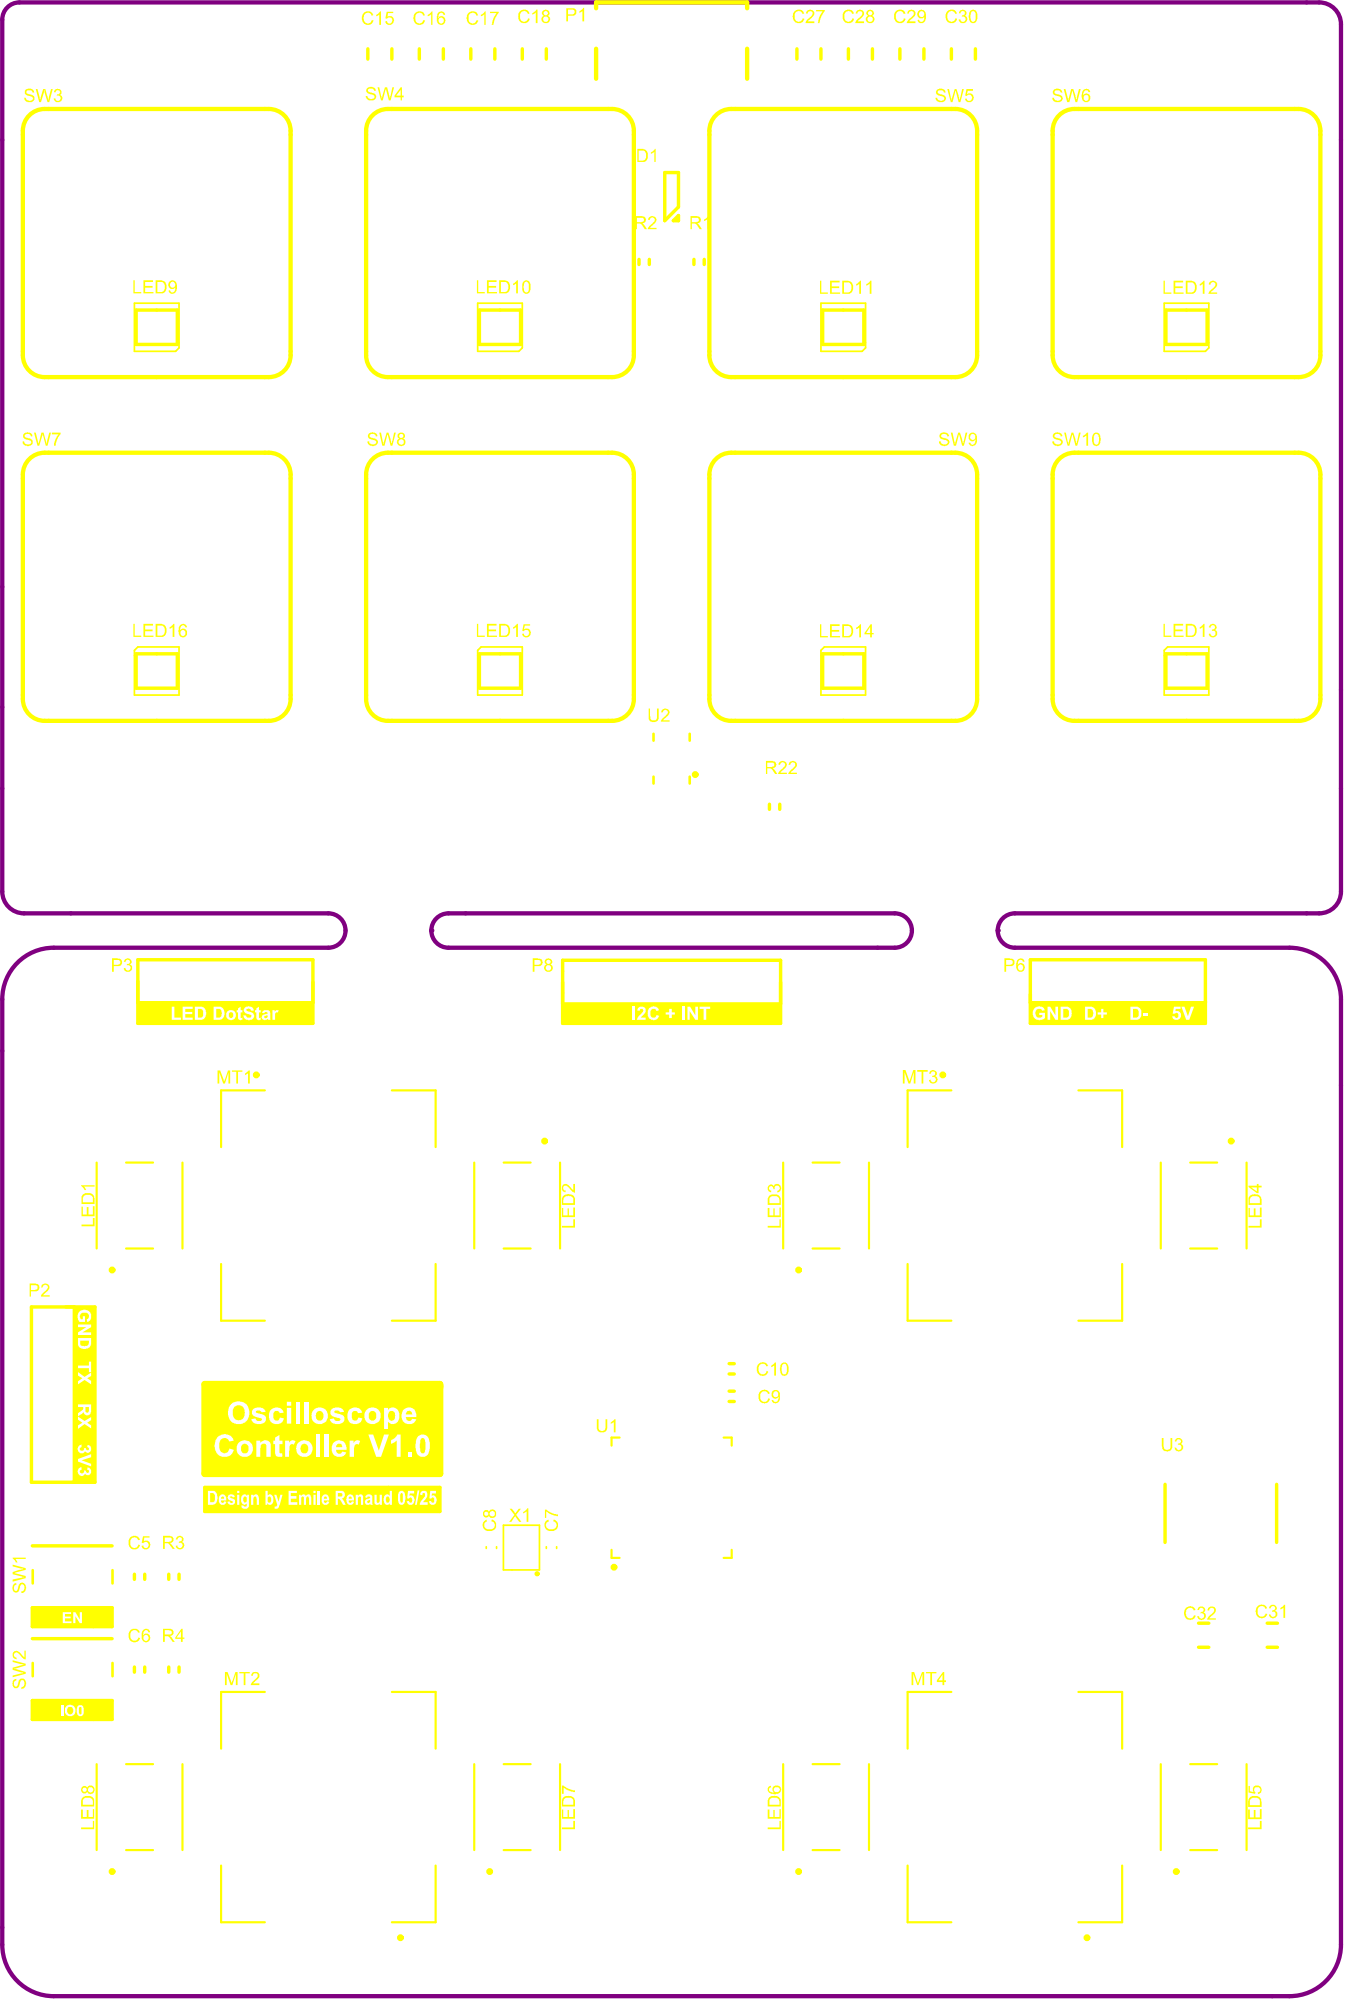
[picture p25: page 6]

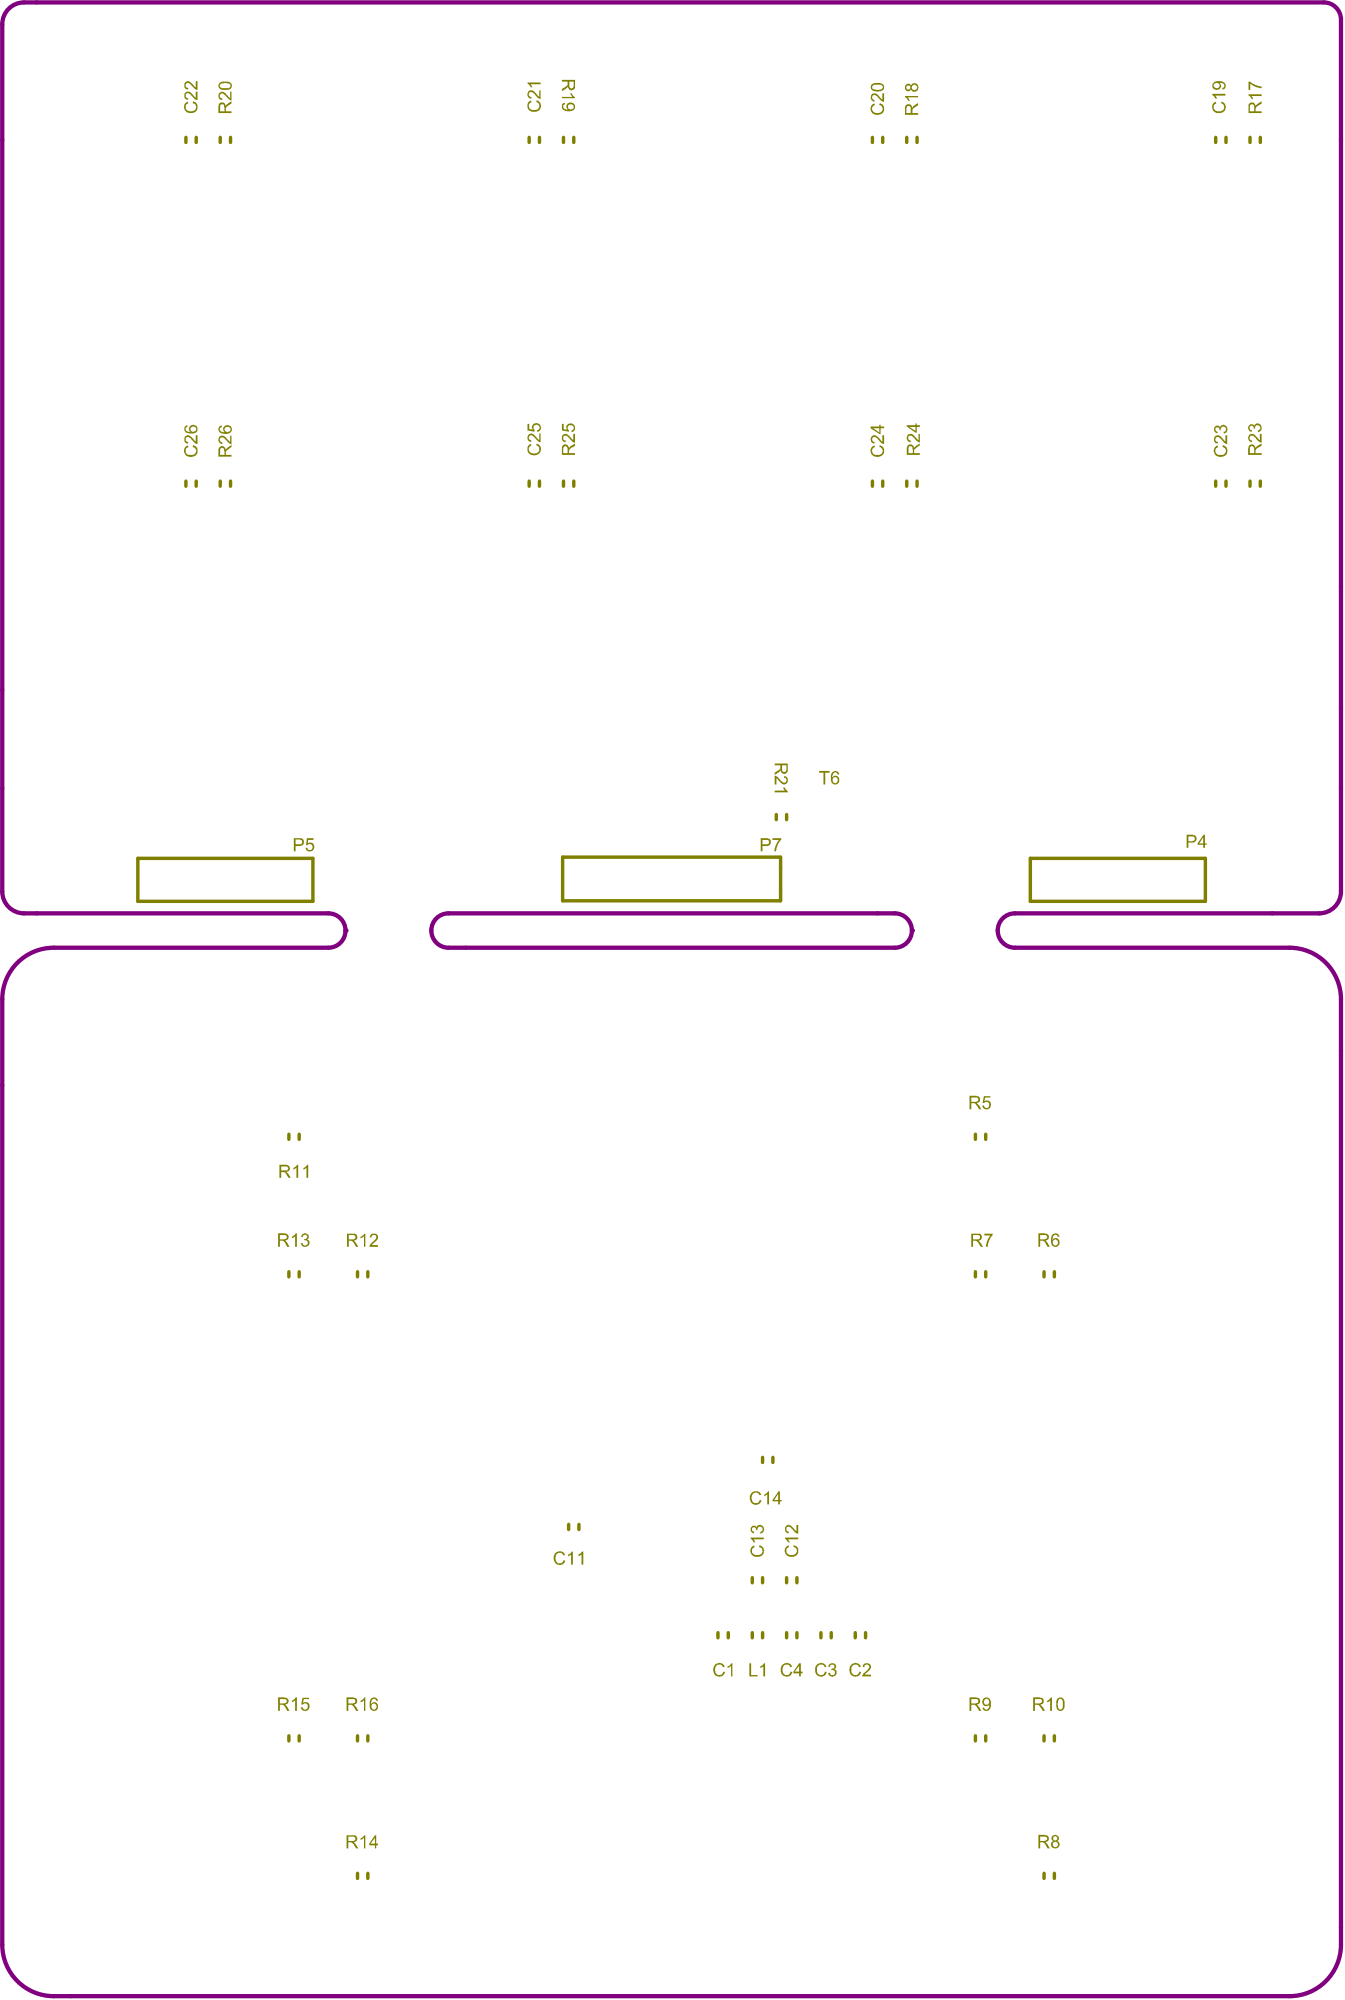
[picture p26: page 7]
