emilerenaud/oscillope_extender/(list of files, drawings)

Other design files:
CherryMX.SchDoc
MCU.SchDoc
oscilloscope_ext.PcbDoc
oscilloscope_ext.PrjPcb
pcb_key.PcbDoc
RotaryEncoder.SchDoc
