emilerenaud/oscillope_extender/(commit log)

2025-06-26 code + casing
    [top_casing.SLDPRT, top_casing.STL]
2025-06-26 basic esp32 code for encoder
2025-06-27 add io extender + switch/led sync
